TKontu/ltc4368-2s-protector/BOM.csv

Ref | QTY | LCSC Part Number | Manufacture Part Number | Manufacturer | Package | Description
U1 | 1 | C688384 | LTC4368CMS-1#PBF | ADI | MSOP-10 | 2.5V~60V Surface Mount 1 MSOP-10 Surge Suppression ICs RoHS
R4 | 1 | C51934143 | RL2512F61R2m | JIERR | 2512 | 6W 1.2mΩ Alloy Resistor ±100ppm/℃ ±1% 2512 Chip Resistor - Surface Mount
C2 | 1 | C22877898 | CNA6P1X7R2A475KT000A | TDK | 1210 | 4.7uF X7R ±10% 100V 1210 Ceramic Capacitors
R13 | 1 | C2907456 | FRC1206J223 TS | FOJAN | 1206 | 22kΩ ±5% 250mW 1206 Thick Film Resistor
C11 | 1 | C577233 | CC1206KRX7R0BB332 | YAGEO | 1206 | 3.3nF ±10% 100V Ceramic Capacitor X7R 1206
C7 | 1 | C54157527 | CC2220X7R100V475KN | TORCH | 2220 | 4.7uF X7R ±10% 100V 2220 Ceramic Capacitors
C15 | 1 | C282823 | TCC1206X7R105K101HT | CCTC | 1206 | 1uF ±10% 100V Ceramic Capacitor X7R 1206
C6 | 1 | C381466 | FS32X475K101EGG | PSA | 1210 | 4.7uF ±10% 100V Ceramic Capacitor X7R 1210
R7 | 1 | C2778857 | HV03WAF6493T5E | UNI-ROYAL | 603 | 100mW 649kΩ 200V Thick Film Resistor ±100ppm/℃ ±1% 0603 Chip Resistor - Surface Mount
R3 | 1 | C14675 | RC0603FR-07100KL | YAGEO | 603 | 100mW 100kΩ 75V Thick Film Resistor ±100ppm/℃ ±1% 0603 Chip Resistor - Surface Mount RoHS
R1 | 1 | C4219180 | CRCW06031M18FKEA | VISHAY | 603 | 1.18MΩ 100mW Thick Film Resistor ±100ppm/℃ ±1% 0603 Chip Resistor - Surface Mount RoHS
R2 | 1 | C2930117 | FRC0603F5622TS | FOJAN | 603 | 56.2kΩ ±1% 100mW 0603 Thick Film Resistor
C5 | 1 | C344195 | TCC0603X7R224K500CT | CCTC | 603 | 220nF ±10% 50V Ceramic Capacitor X7R 0603
Q2/Q3 | 2 | C52205260 | TPSIR870ADP-T1-GE3 | TECH PUBLIC | PDFN-8(5x6) | 57W 100V 60A 1.2V 6.5mΩ@10V 1 N-channel N-Channel PDFN-8(5x6) Single FETs, MOSFETs
C1 | 1 | TBD | 47uF >=25V radial, D8.0mm body / 3.5mm lead pitch | TBD | Through Hole,D8.0xL11.5mm | 47uF ±20% >=25V aluminium electrolytic. MUST fit footprint CP_Radial_D8.0mm_P3.80mm. Previous C19270695 (D10xL12.5mm, 5.0mm pitch) does NOT fit - reselect before ordering
