TKontu/ltc4368-2s-protector/DC2418-LVC-end/DC2418A-2.kicad_pcb

## KiCad design DC2418-LVC-end/DC2418A-2.kicad_pcb (2026-11-07)

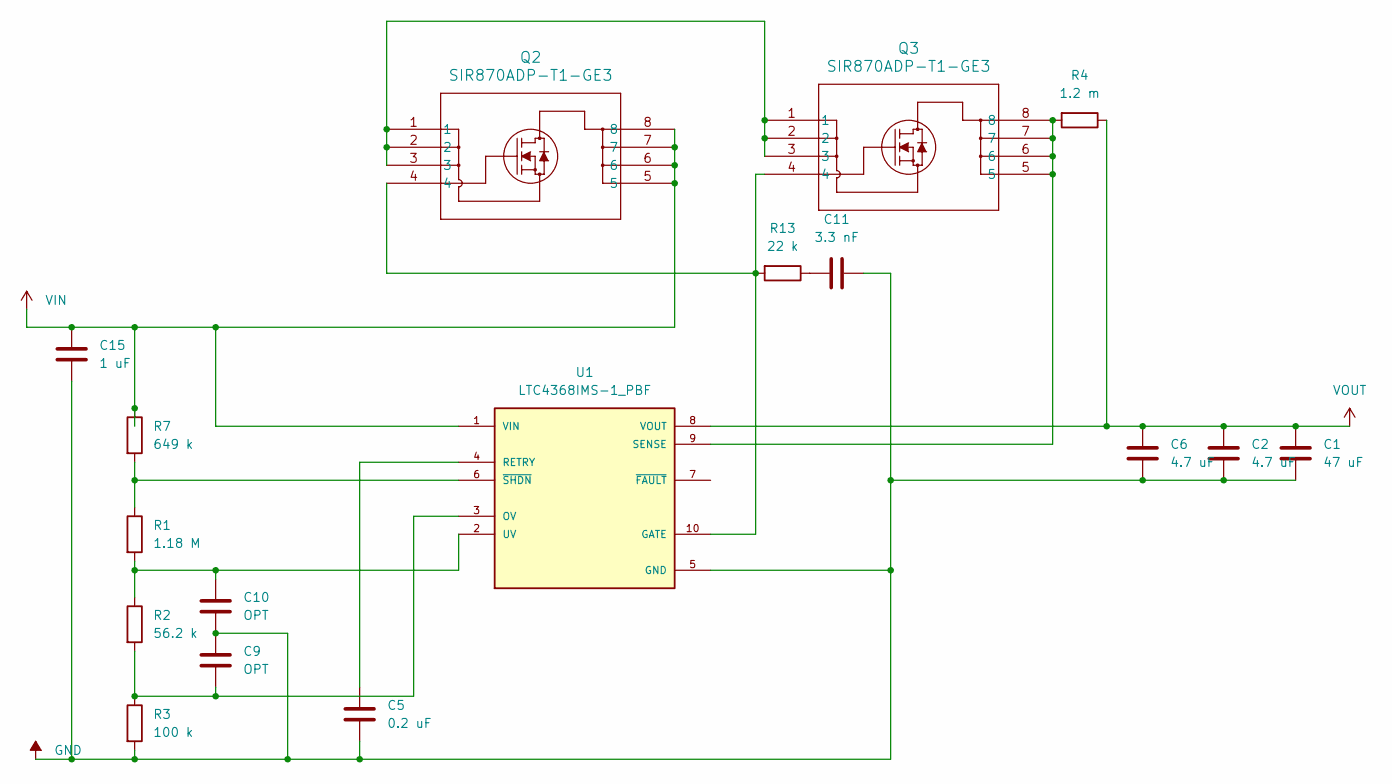
[picture p3: schematic DC2418A-2.kicad_sch]

Parts:
C1: 47 uF
C2, C6: 4.7 uF
C5: 0.2 uF
C9, C10: OPT
C11: 3.3 nF
C15: 1 uF
Q2, Q3: SIR870ADP-T1-GE3; POWERPAK_SO-8_SINGLE_VIS
R1: 1.18 M
R2: 56.2 k
R3: 100 k
R4: 1.2 m
R7: 649 k
R13: 22 k
U1: LTC4368IMS-1_PBF; SOP50P490X110-10N; PARTREV F

Connections:
GND: C1.2, C2.2, C5.2, C6.2, C9.1, C10.2, C11.1, C15.2, R3.2, U1.5 (GND); also elsewhere on the board
unnamed: C11.2, R13.1
unnamed: Q2.1, Q2.2, Q2.3, Q3.1, Q3.2, Q3.3
unnamed: Q2.4, Q3.4, R13.2, U1.10 (GATE)
unnamed: C9.2, R2.2, R3.1, U1.3 (OV)
unnamed: C5.1, U1.4 (RETRY)
unnamed 6: Q3.5, Q3.6, Q3.7, Q3.8, R4.2, U1.9 (SENSE); also elsewhere on the board
unnamed: C10.1, R1.2, R2.1, U1.2 (UV)
unnamed: R1.1, R7.2, U1.6 (~SHDN)
VIN: C15.1, Q2.5, Q2.6, Q2.7, Q2.8, R7.1, U1.1 (VIN); also elsewhere on the board
VOUT: C1.1, C2.1, C6.1, R4.1, U1.8 (VOUT); also elsewhere on the board

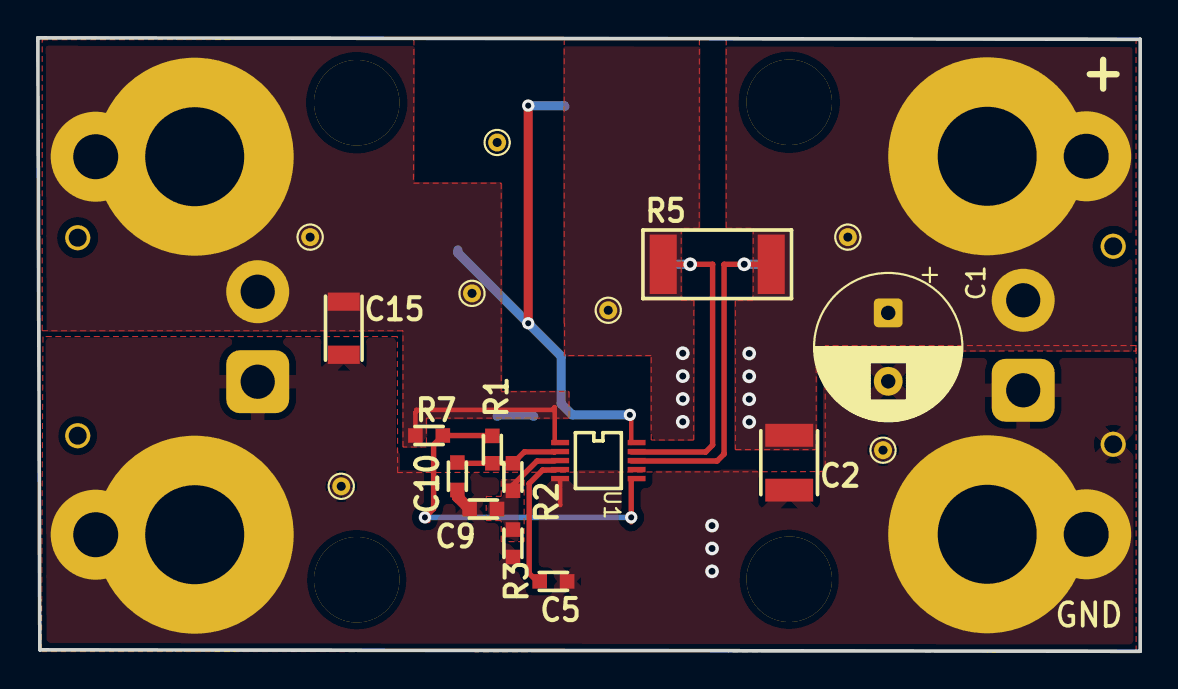
[picture p4: board DC2418A-2.kicad_pcb from above]

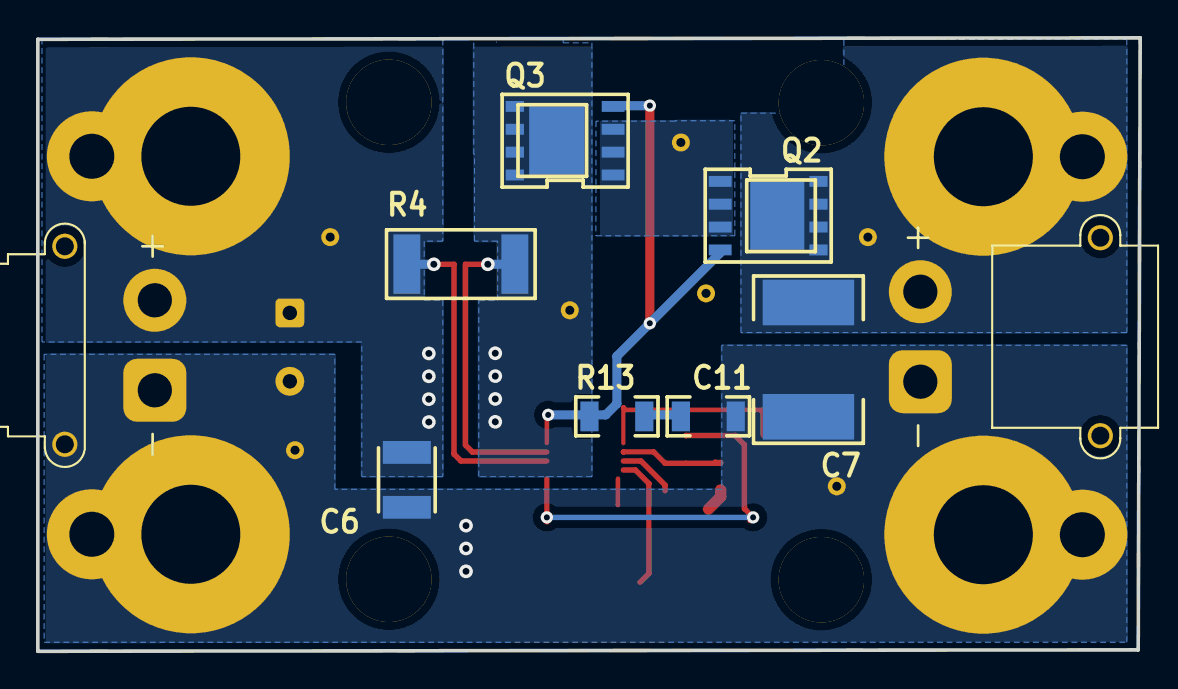
[picture p5: board DC2418A-2.kicad_pcb from below]

Board: 2 copper layers, 61.2 x 34.1 mm, 23 parts (7 on the bottom side), 11 nets.

Other parts of the board:
C7: 4.7 uF; 2220
MH3, MH4, MH5, MH6: KEYSTONE_8831
R5: DNP; 2512

Their connections:
GND: C7.2; also elsewhere on the board
unnamed 6: R5.2; also elsewhere on the board
VIN: C7.1; also elsewhere on the board
VOUT: R5.1; also elsewhere on the board
