TKontu/ltc4368-2s-protector/(commit log)

2026-08-27 Fix C1/C2 value swap, annotate C7/R5, document BOM gaps
    Design fixes (both DC2418-LVC and DC2418-LVC-variant):
    - C1/C2 values were reversed in the schematic. C1 is the THT radial
    (CP_Radial_D8.0mm_P3.80mm) and carries 47 uF; C2 is the 1210 at
    4.7 uF. Swapped to match the PCB footprints and the BOM.
    - C1 and C7 PCB value fields held their package names instead of
    values; set to 47 uF and 4.7 uF.
    - R5 marked DNP. It is the DC2418A -A/-B version-option pair with R4:
    R4 is the live sense position (1.2 mOhm) on this -A build, R5 is the
    -B's 0.02 Ohm slot. Verified R4 and R5 bridge the same two nodes
    (VOUT <-> Net-(U1-SENSE)), so they are parallel alternates and an
    unpopulated R5 is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
    [BOM.csv, DC2418A-2.kicad_pcb, DC2418A-2.kicad_sch, LVC.kicad_pcb, LVC.kicad_sch]
2026-08-27 Fix formatting and clarify mounting hole details
2026-11-07 Add Q2/Q3 thermal pads; regenerate fabrication outputs
    Both boards (DC2418-LVC and DC2418-LVC-variant):
    - Q2/Q3 PDFN-8 footprints now include the exposed drain/thermal pad
    on B.Cu (with B.Mask/B.Paste openings).
    - Re-applied the F.Fab value fixes from 94e85b1 (C1 47 uF, C2 4.7 uF,
    C7 4.7 uF, R5 DNP) on top of the new layout; these do not affect
    any exported layer.
    - Gerbers and drill files regenerated from the updated PCBs
    (KiCad 10.0.7). The variant's previous Gerbers predated the pad
    change.
    Placement, outline, tracks and vias are unchanged. This revision has
    been built and tested with a smoke-stopper.
    [DC2418A-2-B_Mask.gbr, DC2418A-2-B_Paste.gbr, DC2418A-2-B_Silkscreen.gbr, DC2418A-2-Back.gbr, DC2418A-2-Edge_Cuts.gbr, DC2418A-2-F_Mask.gbr, DC2418A-2-F_Paste.gbr, DC2418A-2-F_Silkscreen.gbr]
2026-11-07 Net the Q2/Q3 thermal pads to drain; rename board folders
    - Q2/Q3 thermal pads were unnumbered and had no net, which gave 4 DRC
    errors per board (zone clearance + rear solder-mask bridge against
    the VIN / SENSE drain zones). Renumbered to pad 5 so they take the
    drain net: VIN on Q2, Net-(U1-SENSE) on Q3. Zones refilled; DRC and
    schematic parity are clean on both boards.
    - Copper, mask, paste and drill outputs are geometrically unchanged
    (the pads already merged into the drain zones). Gerbers and drill
    files regenerated.
    - Folders renamed: DC2418-LVC -> DC2418-LVC-end,
    DC2418-LVC-variant -> DC2418-LVC-side.
    - DC2418-LVC-end: removed the leftover DC2418A title-block / assembly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
    [DC2418A-2-B_Mask.gbr, DC2418A-2-B_Paste.gbr, DC2418A-2-B_Silkscreen.gbr, DC2418A-2-Back.gbr, DC2418A-2-Edge_Cuts.gbr, DC2418A-2-F_Mask.gbr, DC2418A-2-F_Paste.gbr, DC2418A-2-F_Silkscreen.gbr]
2026-11-07 Regenerate front/back layout images
    Rendered from DC2418-LVC-end with kicad-cli (SVG export -> PNG):
    front = F.Cu/F.Mask/F.Courtyard/F.Silkscreen/Edge.Cuts,
    back = same B.* layers, mirrored. Shows the Q2/Q3 thermal pads.
